Gennadiy-V/LCRF/LCRF.jpg

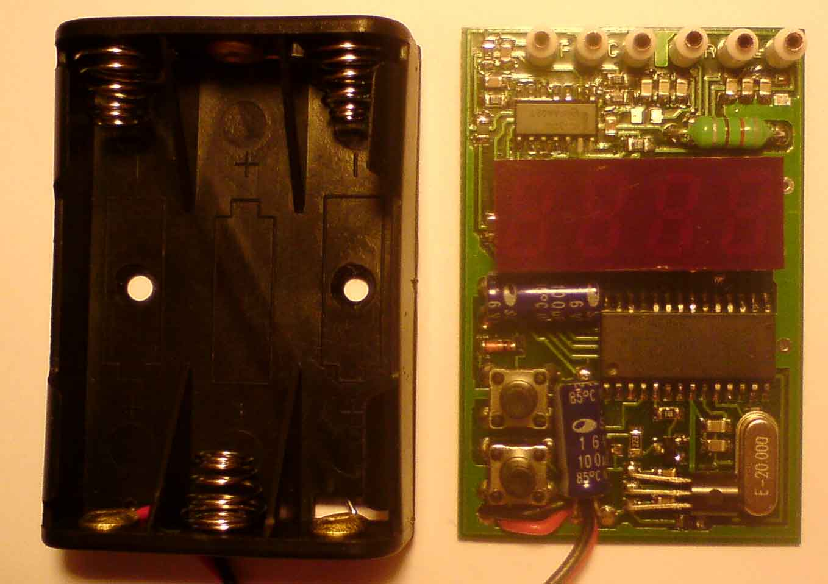
LCRF.jpg
