Gennadiy-V/LCRF/PCB.JPG

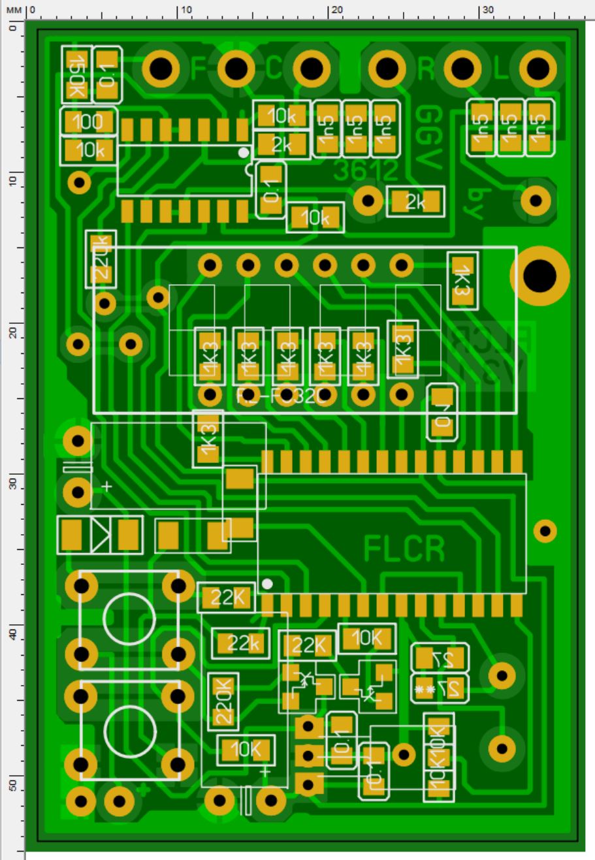
PCB.JPG
