Gennadiy-V/LCRF/README.md

Простой и достаточно точный маленький  измеритль LCRF.
