Gennadiy-V/LCRF/LCRF схема.GIF

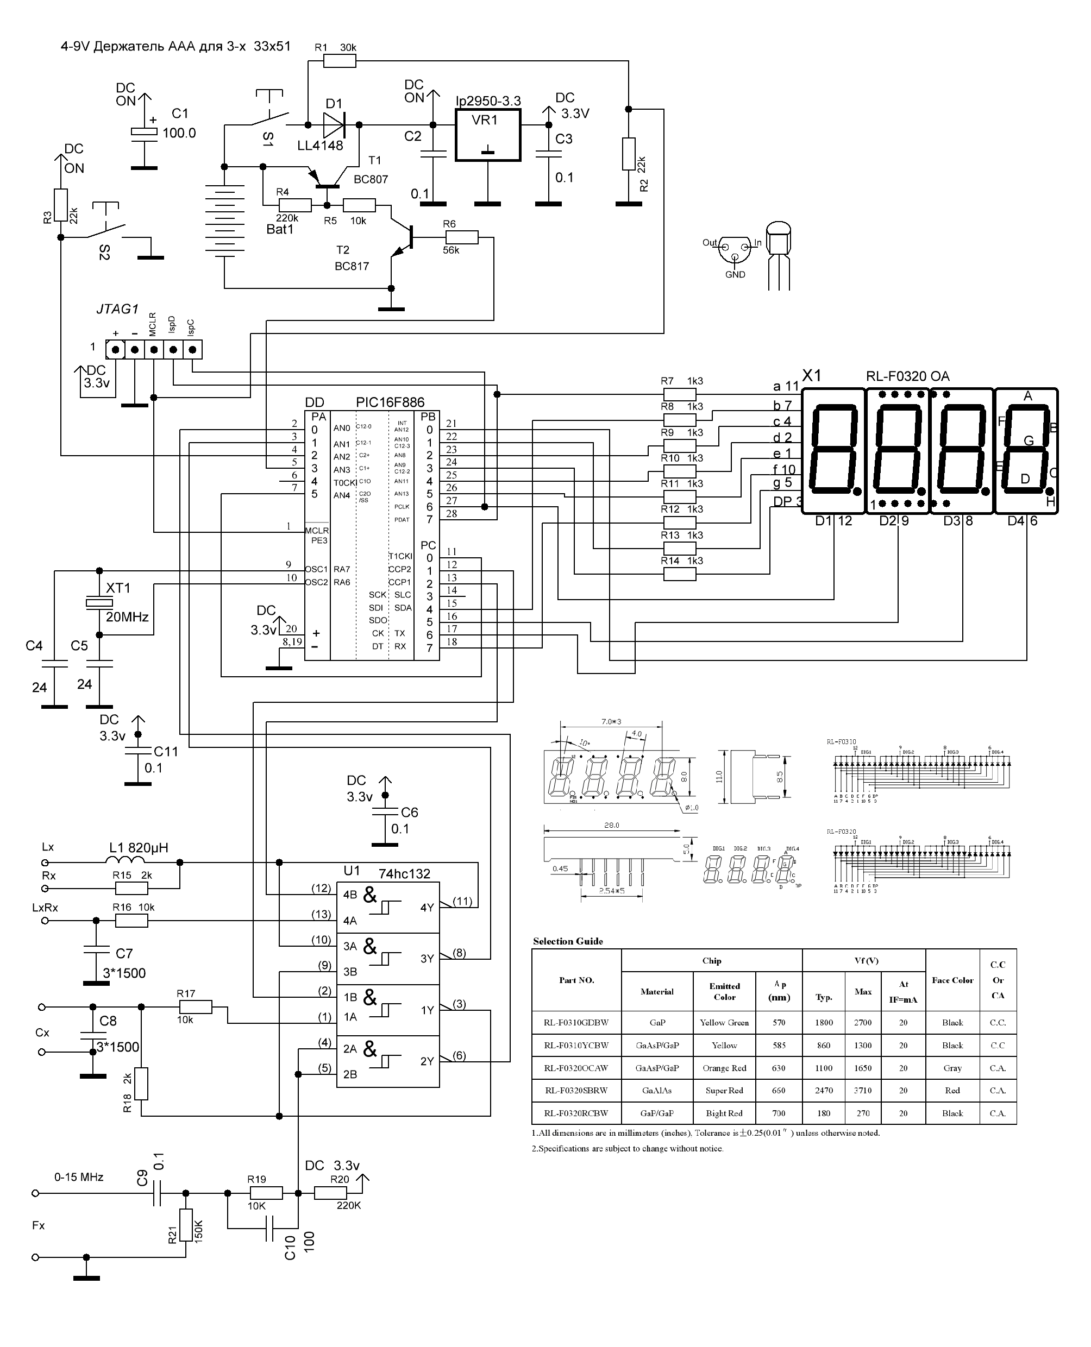
LCRF схема.GIF
